Mental-Noise/Axon/(commit log)

2024-02-04 Replace forked files by Axon project
    [midi2cv.sch]
2024-02-05 Add pitch bend switch
2024-02-05 Fix midi channel selection
    [mental-noise-axon.ino]
2024-03-03 Add missing break in midi commands switch
    [mental-noise-axon.ino]
2024-03-03 Fix string typing in debug
    [mental-noise-axon.ino]
2024-06-18 Fix clock / gate accuracy
    [mental-noise-axon.ino]
2024-06-18 Update schematics
2024-06-27 Fix highest note mode
    [mental-noise-axon.ino]
